Renkin42/82Nix6/README.md

# 82Nix6
An open hardware Nixie Tube Internet Radio alarm clock.
