Renkin42/82Nix6/pcb/clock_exports/display.sch.png

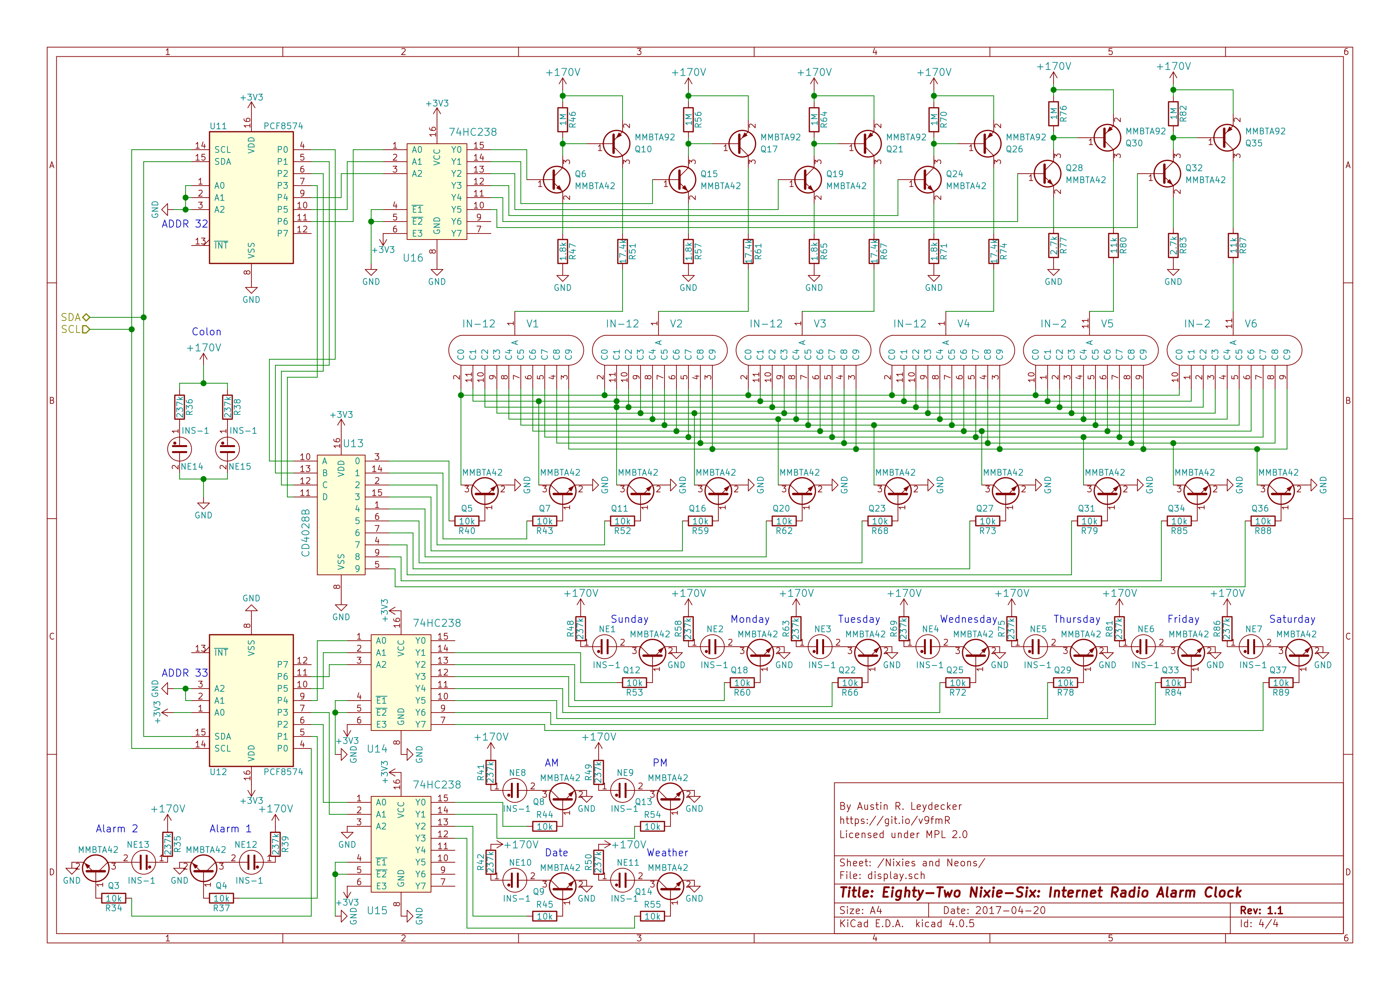
pcb/clock_exports/display.sch.png
