Renkin42/82Nix6/pcb/clock_exports/MP3_Decoder.sch.png

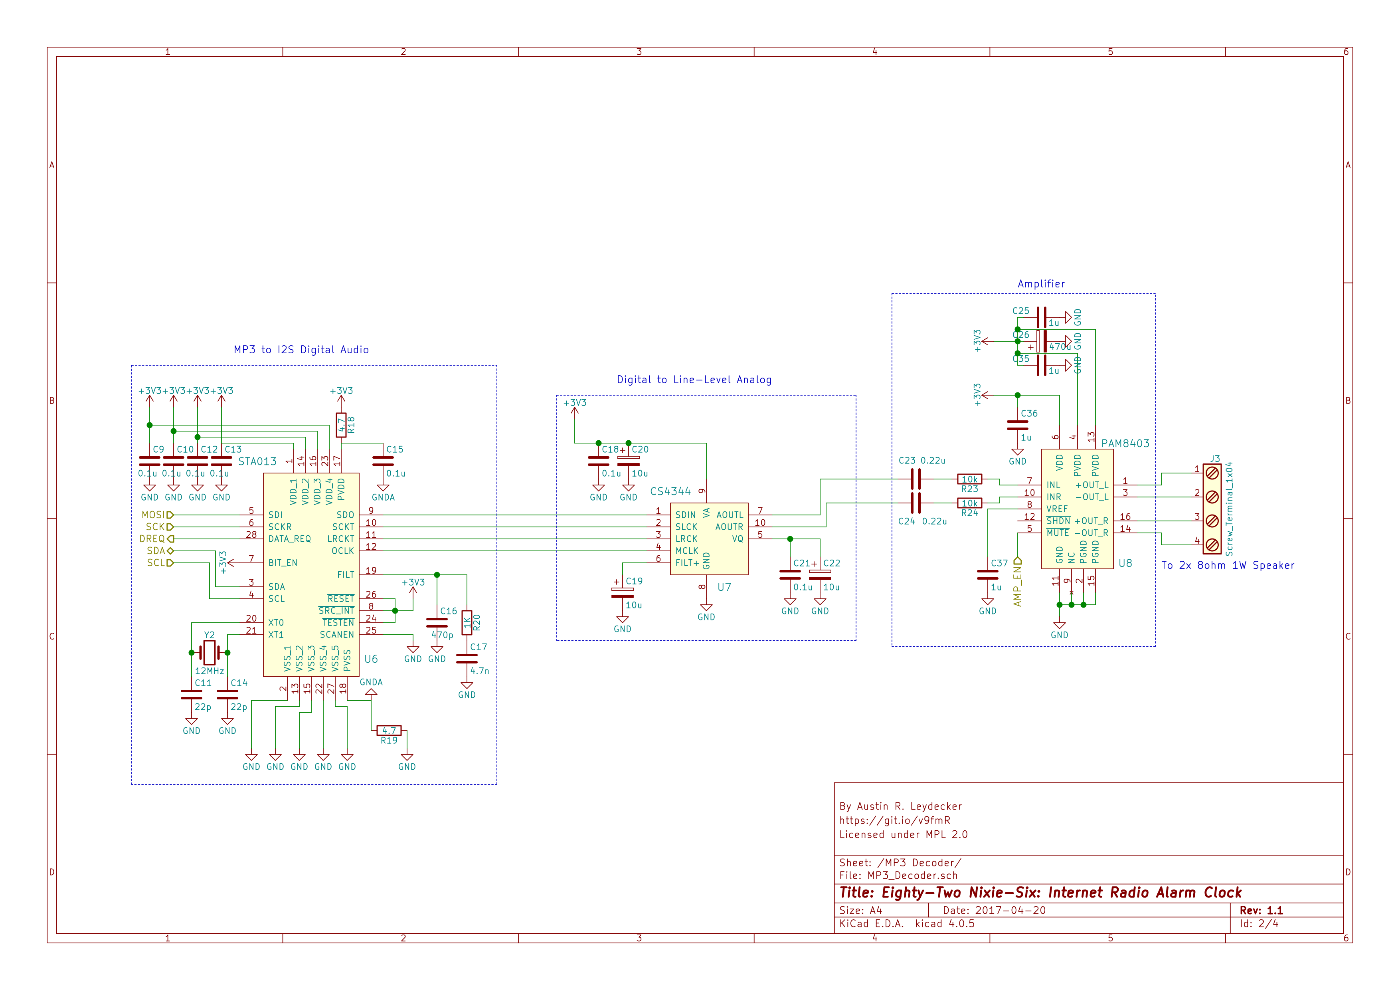
pcb/clock_exports/MP3_Decoder.sch.png
