Renkin42/82Nix6/pcb/clock_exports/NixieClock.sch.png

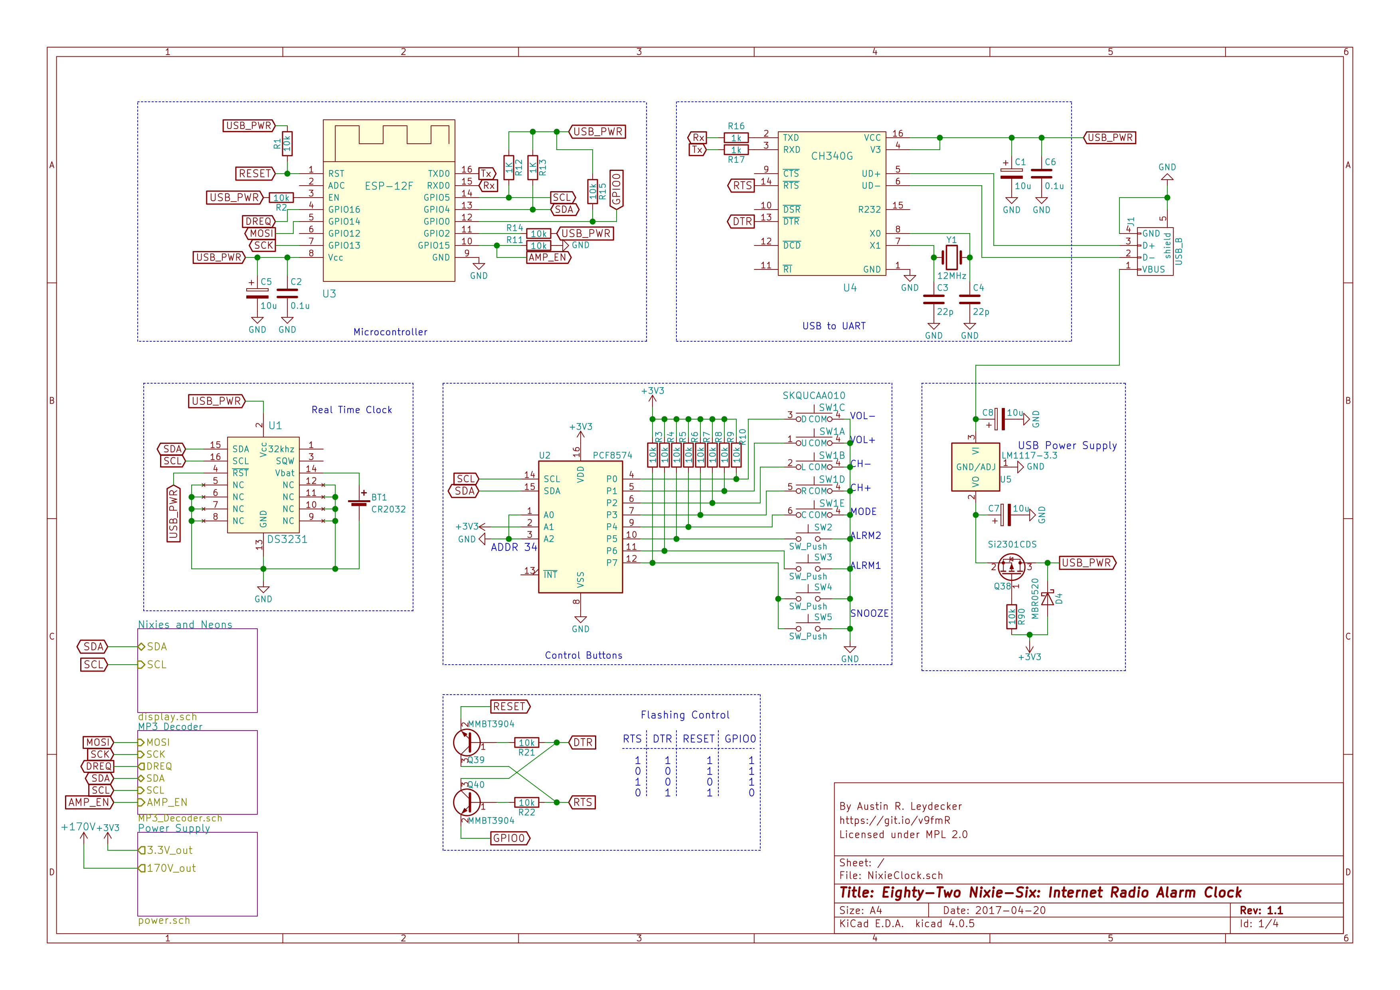
pcb/clock_exports/NixieClock.sch.png
