Renkin42/82Nix6/pcb/clock_exports/power.sch.png

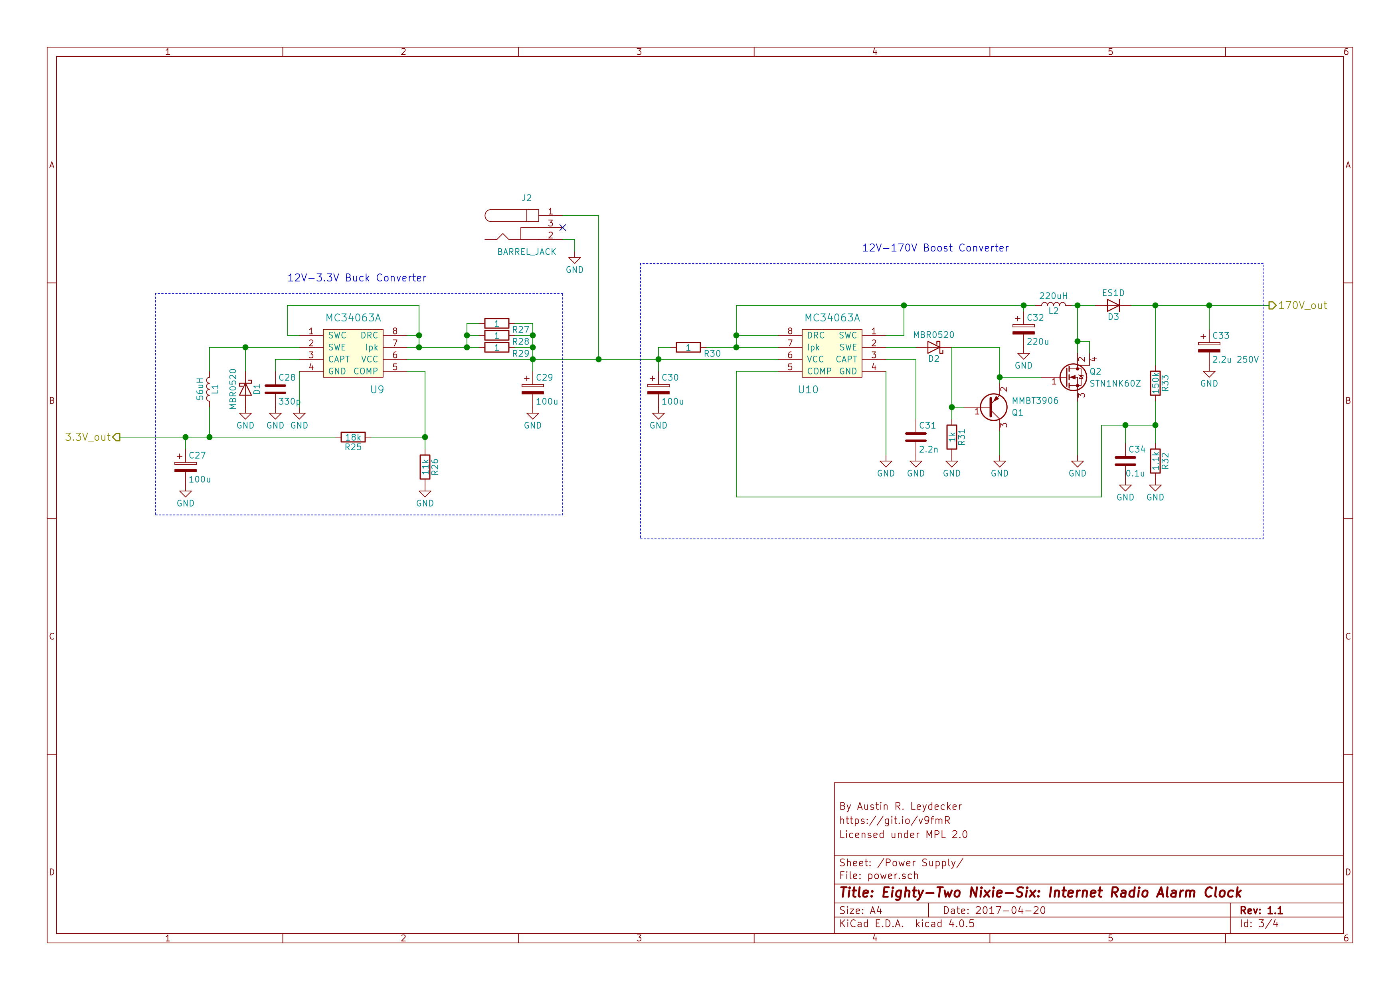
pcb/clock_exports/power.sch.png
