Renkin42/82Nix6/pcb/clock_footprints_3d/ESPModule.FCStd

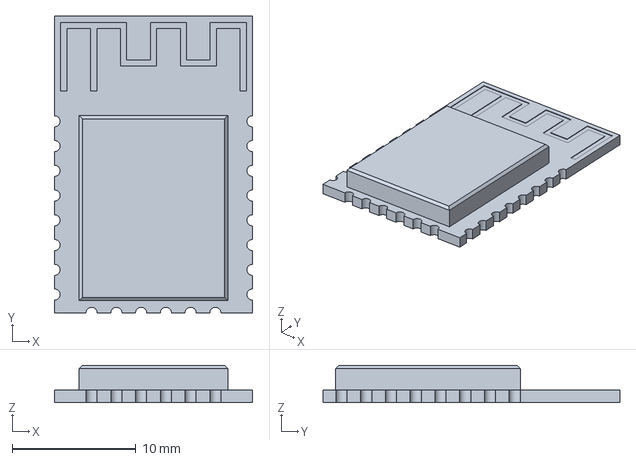
[picture p5: CAD file, 2017-04-18]
pcb/clock_footprints_3d/ESPModule.FCStd
16.0 x 24.0 x 3.00 mm
