Renkin42/82Nix6/pcb/clock_footprints_3d/NixiePin.FCStd

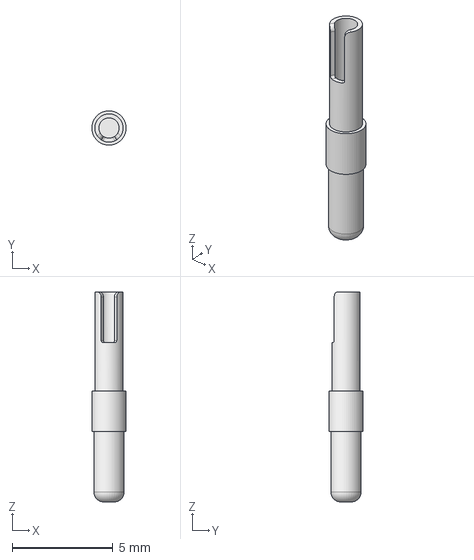
[picture p6: CAD file, 2017-04-11]
pcb/clock_footprints_3d/NixiePin.FCStd
1.70 x 1.70 x 10.4 mm
