Renkin42/82Nix6/pcb/clock_footprints_3d/RadialInductor.FCStd

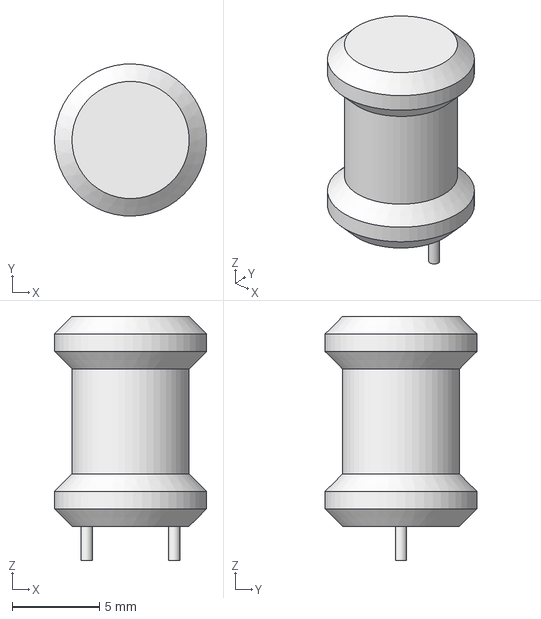
[picture p7: CAD file, 2017-04-11]
pcb/clock_footprints_3d/RadialInductor.FCStd
8.69 x 8.70 x 13.9 mm
