Renkin42/82Nix6/pcb/clock_footprints_3d/BatteryHolder.FCStd

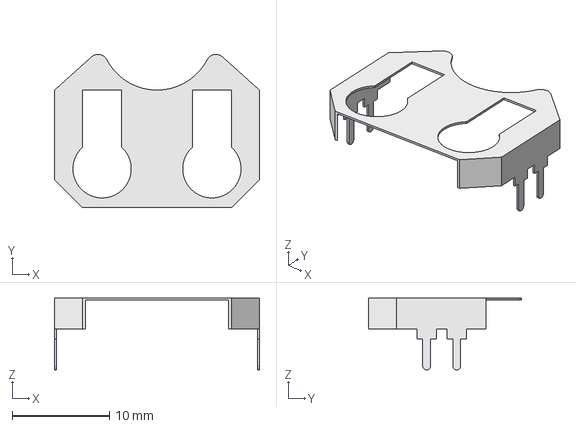
[picture p8: CAD file, 2017-04-11]
pcb/clock_footprints_3d/BatteryHolder.FCStd
21.1 x 15.8 x 7.40 mm
