Renkin42/82Nix6/pcb/clock_footprints_3d/RadialInductor2.FCStd

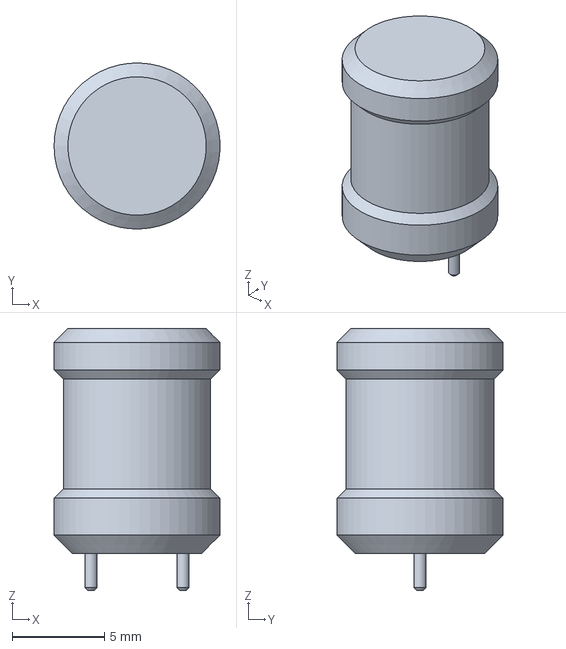
[picture p9: CAD file, 2017-04-11]
pcb/clock_footprints_3d/RadialInductor2.FCStd
8.99 x 9.00 x 14.2 mm
