Renkin42/82Nix6/pcb/clock_exports/NixieClock.pdf

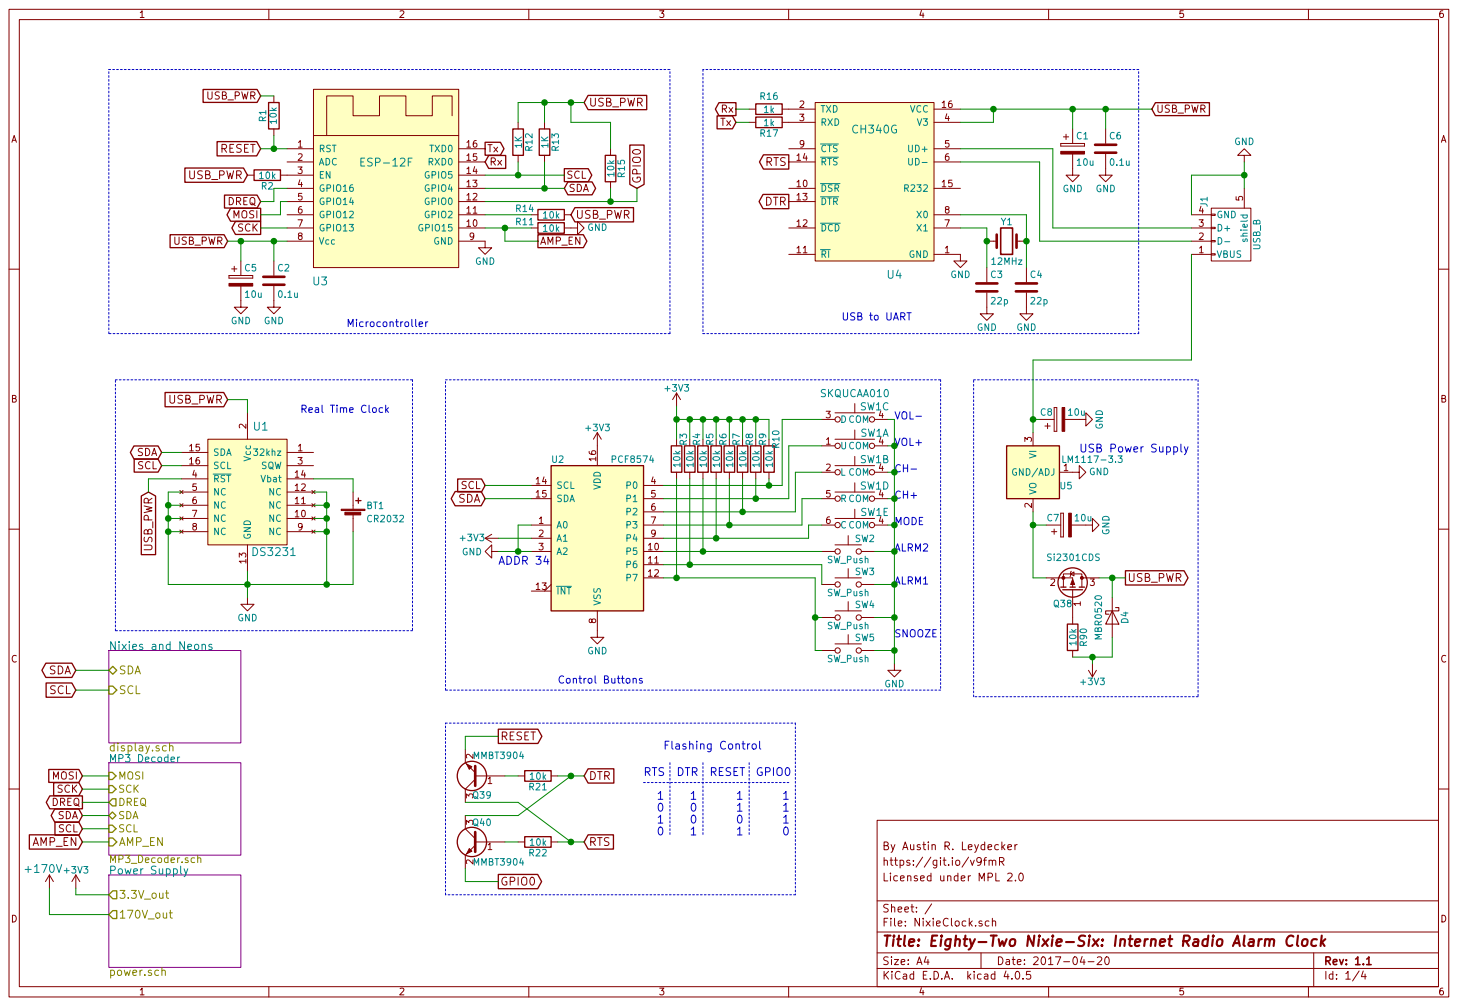
[picture p10: page 1]

5J1 USB_B GND USB to UART C5

By Austin R. Leydecker
https://git.io/v9fmR
File: NixieClock.sch Sheet: / Licensed under MPL 2.0

Id: 1/4 Title: Eighty-Two Nixie-Six: Internet Radio Alarm Clock

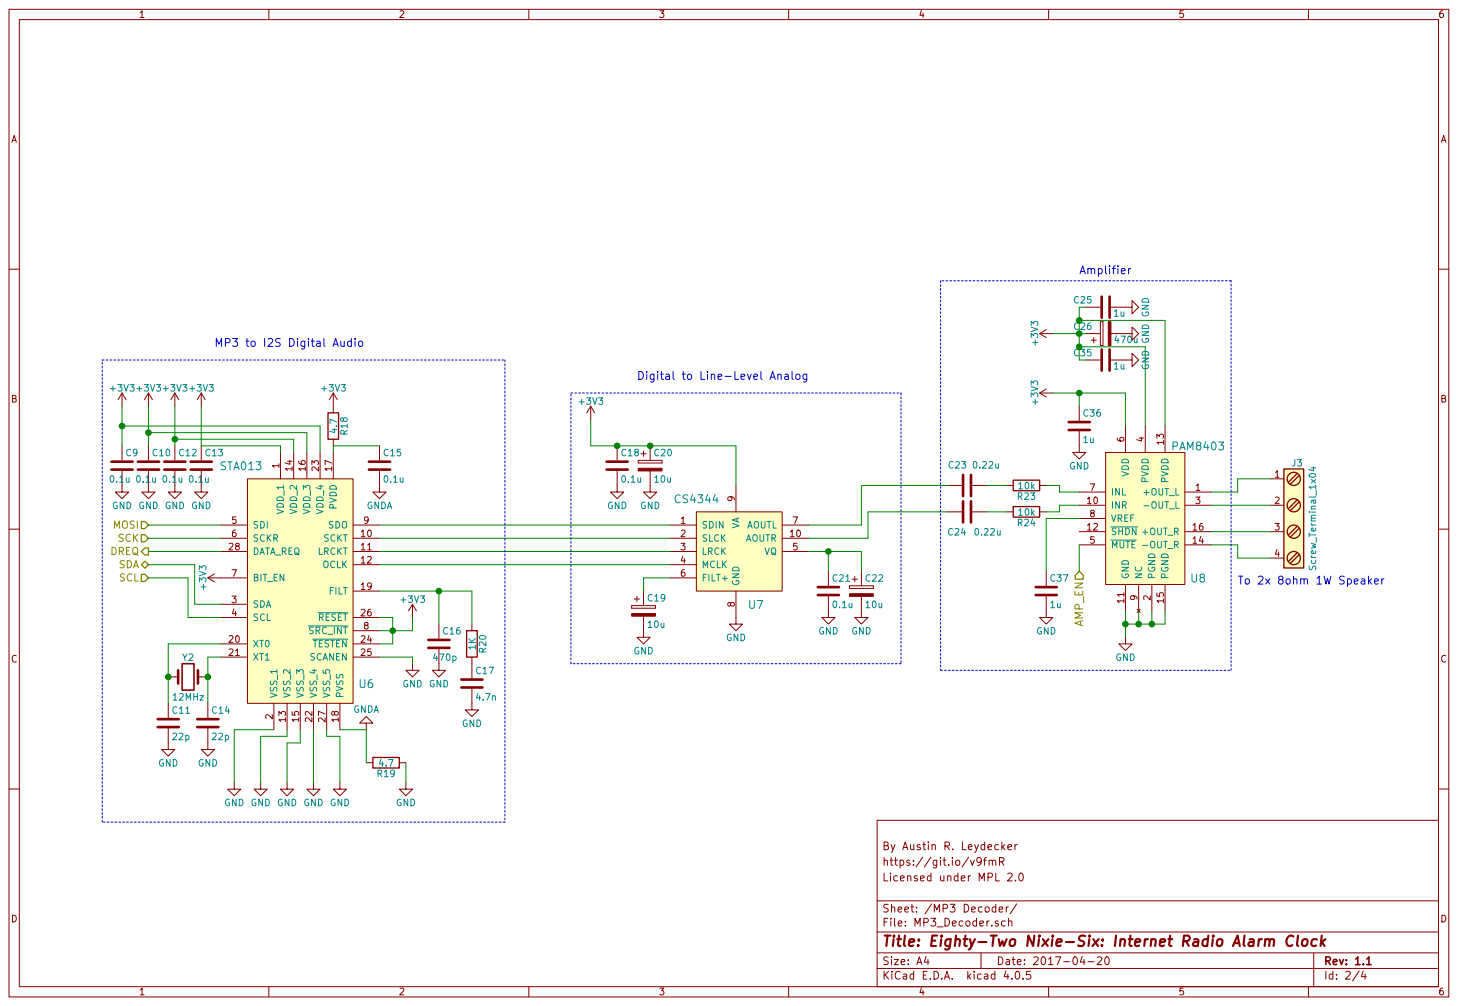
[picture p11: page 2]

Digital to Line-Level Analog

4.7n GND GND MOSI SCK DREQ

2 SDA 3 SCL 4 SDI 5 SCKR 6 BIT_EN 7 SRC_INT 8 SDO 9 SCKT 10 XT0 20

10u GND GND GND GND

https://git.io/v9fmR
File: MP3_Decoder.sch Sheet: /MP3 Decoder/ Licensed under MPL 2.0

Id: 2/4 Title: Eighty-Two Nixie-Six: Internet Radio Alarm Clock

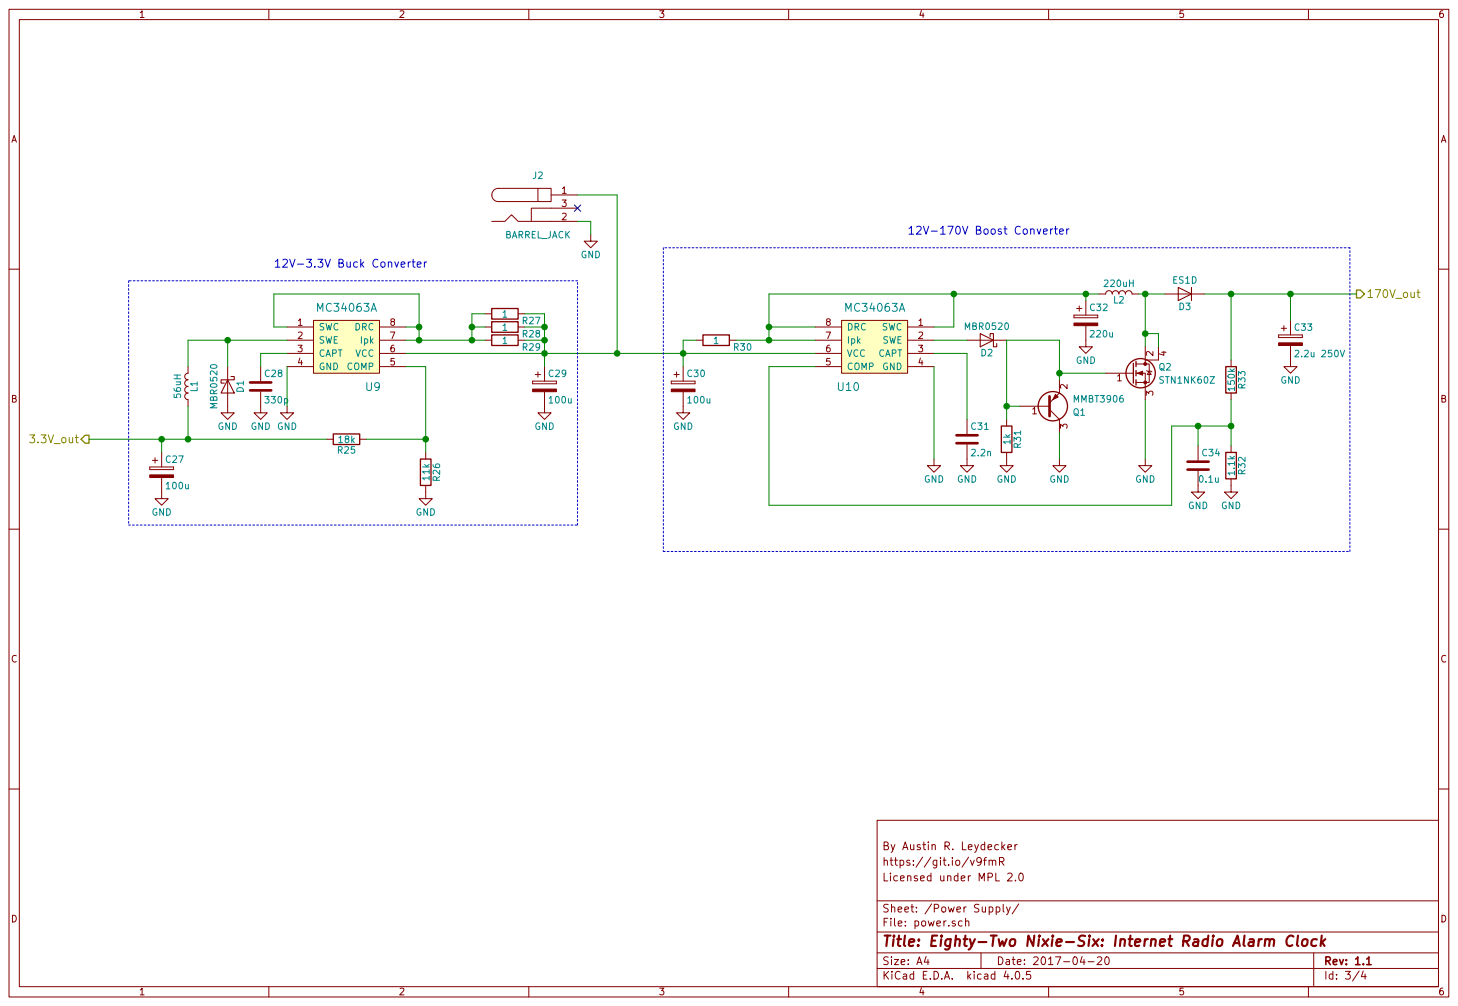
[picture p12: page 3]

By Austin R. Leydecker
https://git.io/v9fmR
Sheet: /Power Supply/ Licensed under MPL 2.0

File: power.sch
Id: 3/4 Title: Eighty-Two Nixie-Six: Internet Radio Alarm Clock

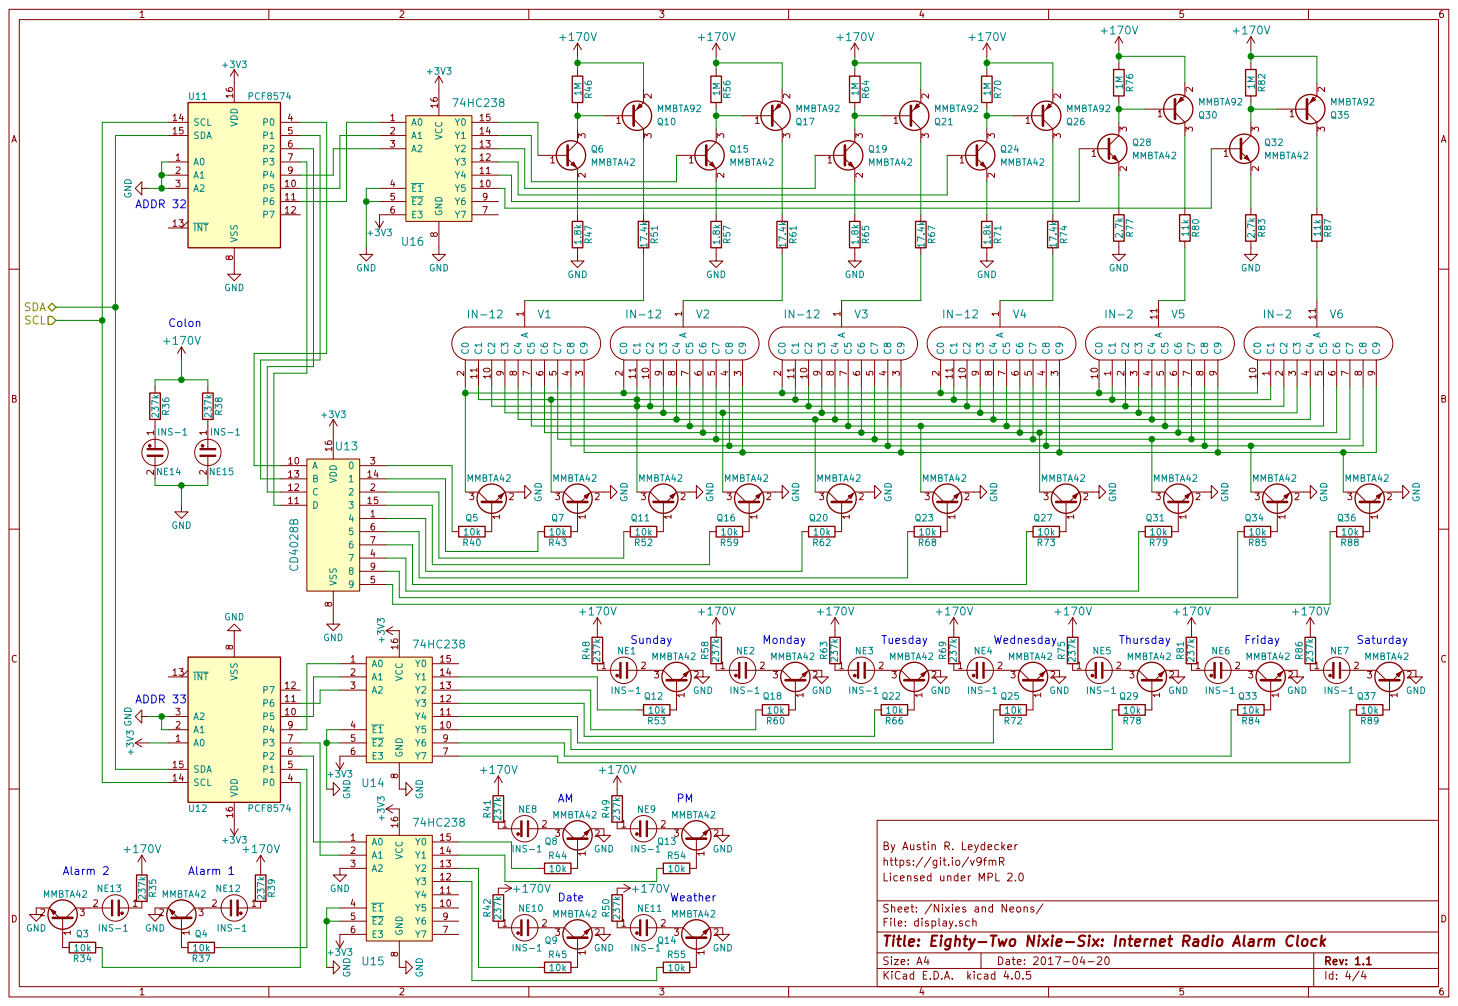
[picture p13: page 4]

INS-1 GND Colon ADDR 32 ADDR 33

2 3 Q24 MMBTA42 1MR70 1.8k R71 R74 17.4k GND GND GND GND

File: display.sch Sheet: /Nixies and Neons/ Licensed under MPL 2.0

Id: 4/4 Title: Eighty-Two Nixie-Six: Internet Radio Alarm Clock
