Renkin42/82Nix6/pcb/NixieClock.kicad_pcb

## KiCad design pcb/NixieClock.kicad_pcb (2017-04-21)

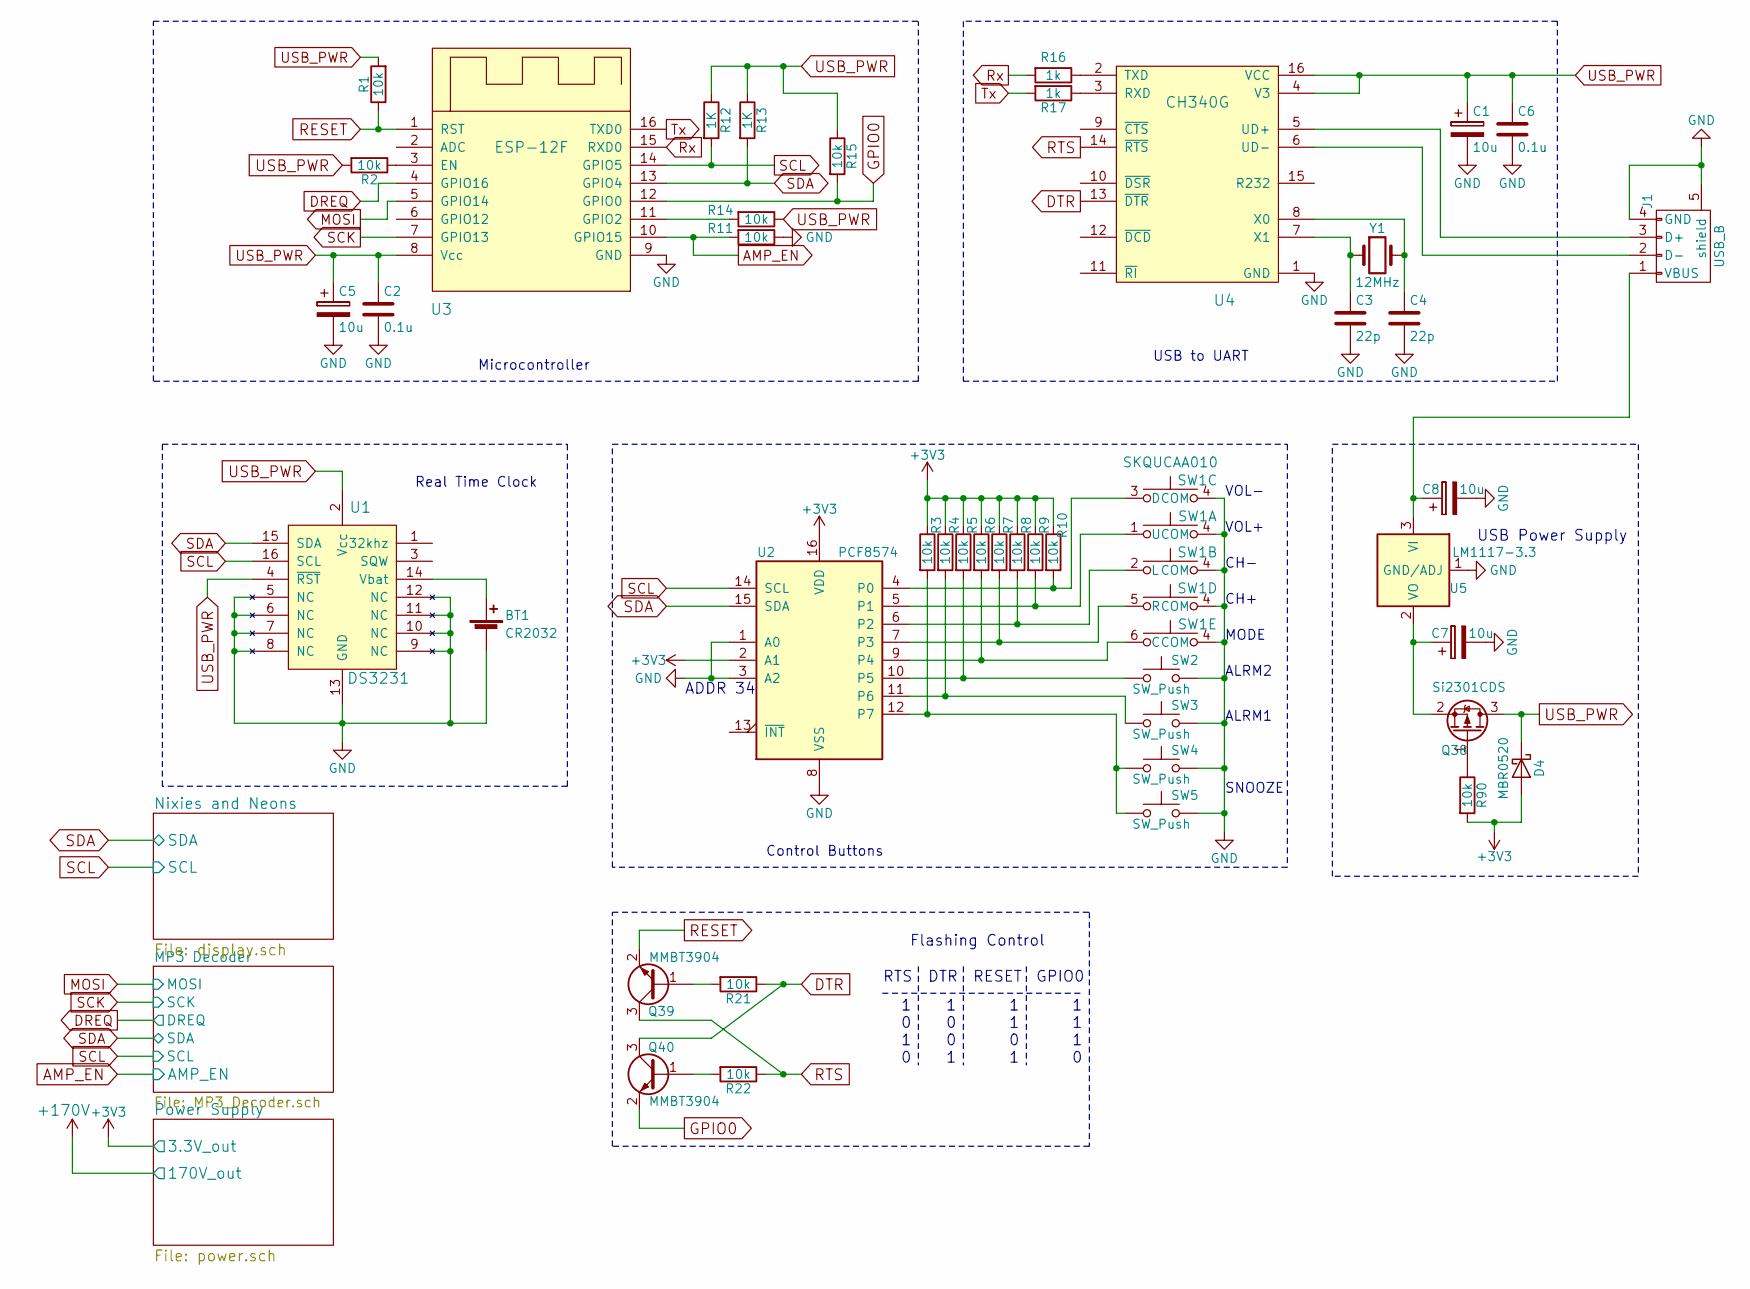
[picture p14: schematic NixieClock.sch, Eighty-Two Nixie-Six: Internet Radio Alarm Clock]

Parts:
BT1: CR2032; Linx_Battery_Holder
C1, C5, C7, C8: 10u; CP_Tantalum_Case-A_EIA-3216-18_Hand
C2, C6: 0.1u; C_0805_HandSoldering
C3, C4: 22p; C_0805_HandSoldering
D4: MBR0520; D_SOD-123
J1: USB_B
Q38: Si2301CDS; SOT-23_Handsoldering
Q39, Q40: MMBT3904; SOT-23_Handsoldering
R1, R2, R3, R4, R5, R6, R7, R8, R9, R10, R11, R14, R15, R21, R22, R90: 10k; R_0805_HandSoldering
R12, R13: 1K; R_0805_HandSoldering
R16, R17: 1k; R_0805_HandSoldering
SW1: SKQUCAA010
SW2, SW3: SW_Push; SW_PUSH_6mm
SW4, SW5: SW_Push; SW_Tactile_SKHH_Angled
U1: DS3231; SOIC-16W_7.5x10.3mm_Pitch1.27mm
U2: PCF8574; SOIC-16W_7.5x10.3mm_Pitch1.27mm
U3: ESP-12F; ESP_SMD_Module
U4: CH340G; SOIC-16_3.9x9.9mm_Pitch1.27mm
U5: LM1117-3.3; SOT-223
Y1: 12MHz; Crystal_HC49-4H_Vertical

Connections:
+3V3: D4.2 (A), R3.1, R4.1, R5.1, R6.1, R7.1, R8.1, R9.1, R10.1, R90.2, U2.2 (A1), U2.16 (VDD); also elsewhere on the board
AMP_EN: R11.2, U3.10 (GPIO15); also elsewhere on the board
DREQ: U3.4 (GPIO16); also elsewhere on the board
DTR: Q40.3 (C), R21.1, U4.13 (~DTR)
GND: BT1.2 (-), C1.2, C2.2, C3.2, C4.2, C5.2, C6.2, C7.2, C8.2, J1.4 (GND), J1.5 (shield), R11.1, SW1.4 (COM), SW2.2, SW3.2, SW4.2, SW5.2, U1.5 (NC), U1.6 (NC), U1.7 (NC), U1.8 (NC), U1.9 (NC), U1.10 (NC), U1.11 (NC), U1.12 (NC), U1.13 (GND), U2.1 (A0), U2.3 (A2), U2.8 (VSS), U3.9 (GND), U4.1 (GND), U5.1 (GND/ADJ); also elsewhere on the board
GPIO0: Q40.2 (E), R15.2, U3.12 (GPIO0)
MOSI: U3.5 (GPIO14); also elsewhere on the board
unnamed: BT1.1 (+), U1.14 (Vbat)
unnamed: C3.1, U4.7 (X1), Y1.1
unnamed: C4.1, U4.8 (X0), Y1.2
unnamed: C7.1, Q38.2 (S), U5.2 (VO), U5.4 (VO)
unnamed: C8.1, J1.1 (VBUS), U5.3 (VI)
unnamed: J1.2 (D-), U4.6 (UD-)
unnamed: J1.3 (D+), U4.5 (UD+)
unnamed: Q38.1 (G), R90.1
unnamed: Q39.1 (B), R21.2
unnamed: Q40.1 (B), R22.2
unnamed: R2.1, U3.3 (EN)
unnamed: R3.2, SW4.1, SW5.1, U2.12 (P7)
unnamed: R4.2, SW3.1, U2.11 (P6)
unnamed: R5.2, SW2.1, U2.10 (P5)
unnamed: R6.2, SW1.6 (C), U2.9 (P4)
unnamed: R7.2, SW1.5 (R), U2.7 (P3)
unnamed: R8.2, SW1.2 (L), U2.6 (P2)
unnamed: R9.2, SW1.1 (U), U2.5 (P1)
unnamed: R10.2, SW1.3 (D), U2.4 (P0)
unnamed: R14.2, U3.11 (GPIO2)
unnamed: R16.1, U4.2 (TXD)
unnamed: R17.1, U4.3 (RXD)
RESET: Q39.2 (E), R1.1, U3.1 (RST)
RTS: Q39.3 (C), R22.1, U4.14 (~RTS)
Rx: R16.2, U3.15 (RXD0)
SCK: U3.7 (GPIO13); also elsewhere on the board
SCL: R12.2, U1.16 (SCL), U2.14 (SCL), U3.14 (GPIO5); also elsewhere on the board
SDA: R13.2, U1.15 (SDA), U2.15 (SDA), U3.13 (GPIO4); also elsewhere on the board
Tx: R17.2, U3.16 (TXD0)
USB_PWR: C1.1, C2.1, C5.1, C6.1, D4.1 (K), Q38.3 (D), R1.2, R2.2, R12.1, R13.1, R14.1, R15.1, U1.2 (Vcc), U1.4 (~RST), U3.8 (Vcc), U4.4 (V3), U4.16 (VCC)

Notes on the sheet:
ADDR 34
Microcontroller
Control Buttons
VOL+
VOL-
CH-
CH+
MODE
ALRM1
ALRM2
SNOOZE
Real Time Clock
USB to UART
USB Power Supply
RTS
DTR
RESET
GPIO0
1 0 1 0
1 0 0 1
1 1 0 1
1 1 1 0
Flashing Control

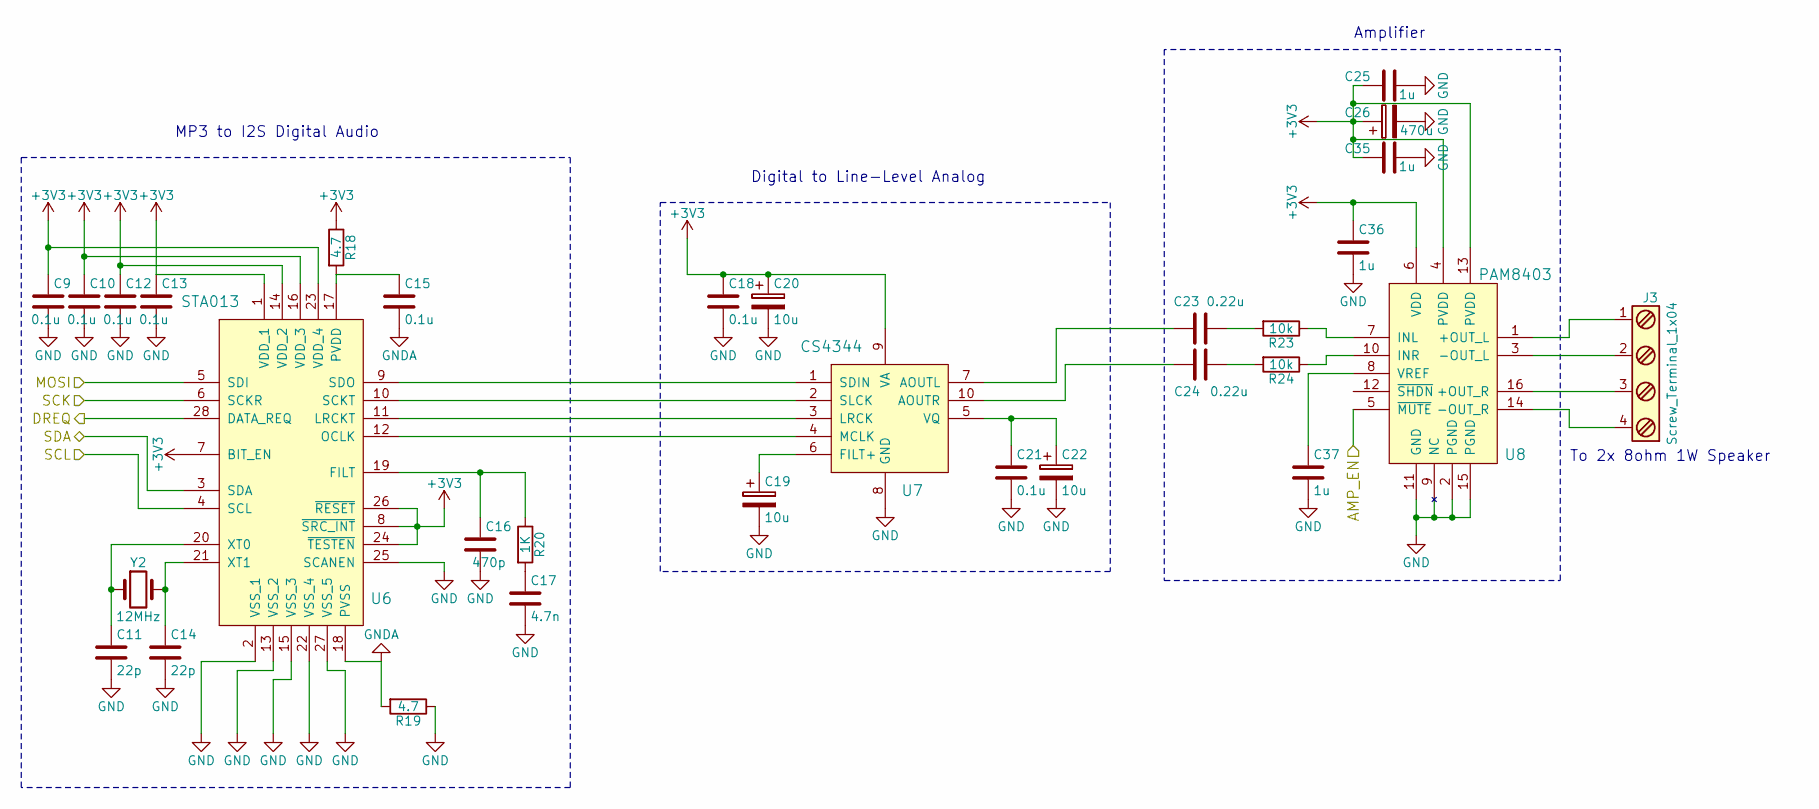
[picture p15: schematic MP3_Decoder.sch, Eighty-Two Nixie-Six: Internet Radio Alarm Clock]

Parts:
C9, C10, C12, C13, C15, C18, C21: 0.1u; C_0805_HandSoldering
C11, C14: 22p; C_0805_HandSoldering
C16: 470p; C_0805_HandSoldering
C17: 4.7n; C_0805_HandSoldering
C19, C20, C22: 10u; CP_Tantalum_Case-A_EIA-3216-18_Hand
C23, C24: 0.22u; C_0805_HandSoldering
C25, C35, C36, C37: 1u; C_0805_HandSoldering
C26: 470u; CP_Radial_D6.3mm_P2.50mm
J3: Screw_Terminal_1x04; TerminalBlock_Pheonix_MPT-2.54mm_4pol
R18, R19: 4.7; R_0805_HandSoldering
R20: 1K; R_0805_HandSoldering
R23, R24: 10k; R_0805_HandSoldering
U6: STA013; SOIC-28W_7.5x17.9mm_Pitch1.27mm
U7: CS4344; MSOP-10_3x3mm_Pitch0.5mm
U8: PAM8403; SOIC-16_3.9x9.9mm_Pitch1.27mm
Y2: 12MHz; Crystal_HC49-4H_Vertical

Connections:
+3V3: C9.1, C10.1, C12.1, C13.1, C18.1, C20.1, C25.1, C26.1, C35.1, C36.1, R18.1, U6.1 (VDD_1), U6.7 (BIT_EN), U6.8 (~SRC_INT), U6.14 (VDD_2), U6.16 (VDD_3), U6.23 (VDD_4), U6.24 (~TESTEN), U6.26 (~RESET), U7.9 (VA), U8.4 (PVDD), U8.6 (VDD), U8.13 (PVDD); also elsewhere on the board
AMP_EN: U8.5 (~MUTE); also elsewhere on the board
DREQ: U6.28 (DATA_REQ); also elsewhere on the board
GND: C9.2, C10.2, C11.2, C12.2, C13.2, C14.2, C16.2, C17.2, C18.2, C19.2, C20.2, C21.2, C22.2, C25.2, C26.2, C35.2, C36.2, C37.2, R19.1, U6.2 (VSS_1), U6.13 (VSS_2), U6.15 (VSS_3), U6.22 (VSS_4), U6.25 (SCANEN), U6.27 (VSS_5), U7.8 (GND), U8.2 (PGND), U8.9 (NC), U8.11 (GND), U8.15 (PGND); also elsewhere on the board
GNDA: C15.2, R19.2, U6.18 (PVSS)
MOSI: U6.5 (SDI); also elsewhere on the board
unnamed: C11.1, U6.20 (XT0), Y2.1
unnamed: C14.1, U6.21 (XT1), Y2.2
unnamed: C15.1, R18.2, U6.17 (PVDD)
unnamed: C16.1, R20.1, U6.19 (FILT)
unnamed: C17.1, R20.2
unnamed: C19.1, U7.6 (FILT+)
unnamed: C21.1, C22.1, U7.5 (VQ)
unnamed: C23.1, U7.7 (AOUTL)
unnamed: C23.2, R23.2
unnamed: C24.1, R24.2
unnamed: C24.2, U7.10 (AOUTR)
unnamed: C37.1, U8.8 (VREF)
unnamed: J3.1, U8.1 (+OUT_L)
unnamed: J3.2, U8.3 (-OUT_L)
unnamed: J3.3, U8.16 (+OUT_R)
unnamed: J3.4, U8.14 (-OUT_R)
unnamed: R23.1, U8.7 (INL)
unnamed: R24.1, U8.10 (INR)
unnamed: U6.9 (SDO), U7.1 (SDIN)
unnamed: U6.10 (SCKT), U7.2 (SLCK)
unnamed: U6.11 (LRCKT), U7.3 (LRCK)
unnamed: U6.12 (OCLK), U7.4 (MCLK)
SCK: U6.6 (SCKR); also elsewhere on the board
SCL: U6.4 (SCL); also elsewhere on the board
SDA: U6.3 (SDA); also elsewhere on the board

Notes on the sheet:
MP3 to I2S Digital Audio
Digital to Line-Level Analog
Amplifier
To 2x 8ohm 1W Speaker

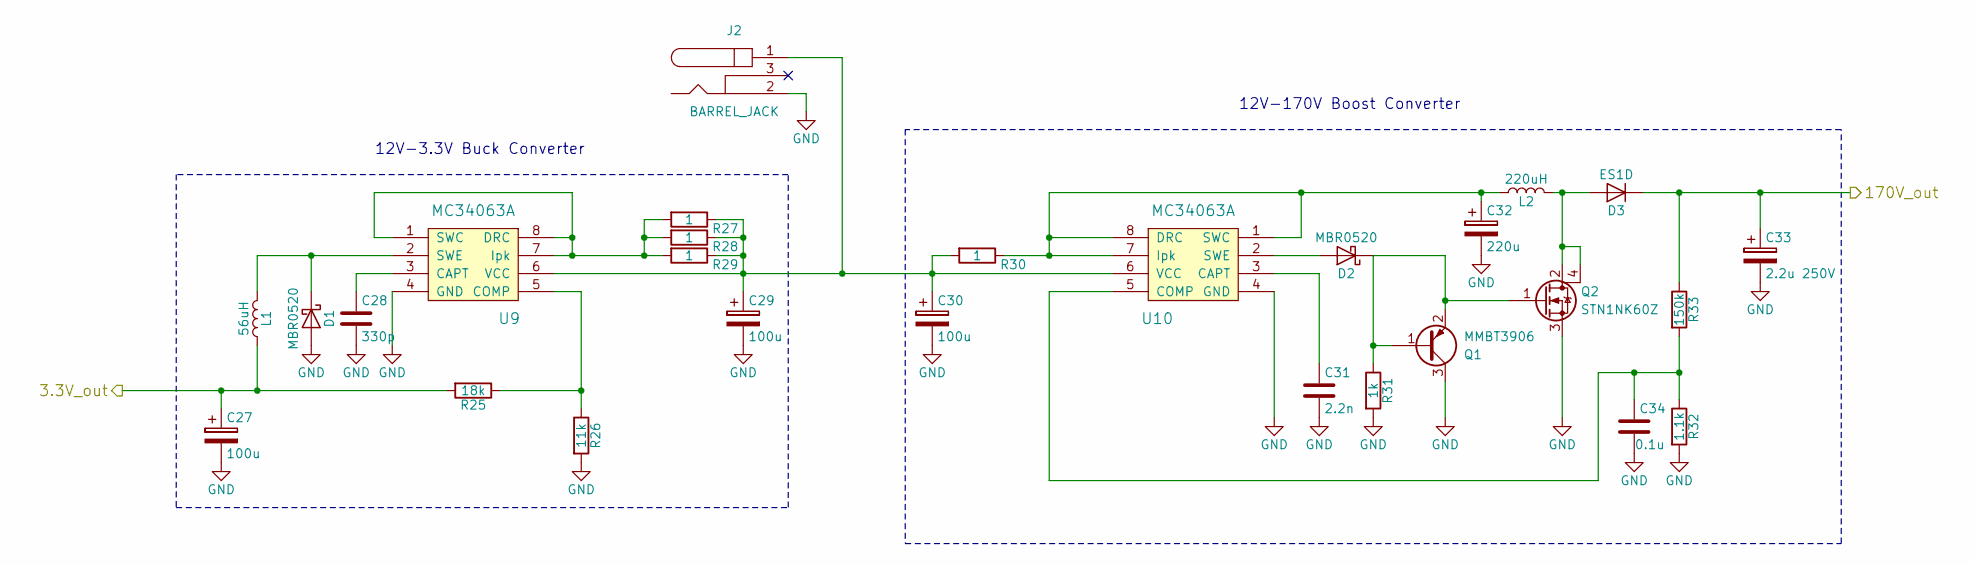
[picture p16: schematic power.sch, Eighty-Two Nixie-Six: Internet Radio Alarm Clock]

Parts:
C27, C29, C30: 100u; CP_Radial_D5.0mm_P2.50mm
C28: 330p; C_0805_HandSoldering
C31: 2.2n; C_0805_HandSoldering
C32: 220u; CP_Radial_D6.3mm_P2.50mm
C33: 2.2u 250V; CP_Radial_D6.3mm_P2.50mm
C34: 0.1u; C_0805_HandSoldering
D1, D2: MBR0520; D_SOD-123
D3: ES1D; D_SOD-123
J2: BARREL_JACK
L1: 56uH; Bourns_RLB9012
L2: 220uH; Bourns_RLB0914
Q1: MMBT3906; SOT-23_Handsoldering
Q2: STN1NK60Z; SOT-223
R25: 18k; R_1206_HandSoldering
R26: 11k; R_1206_HandSoldering
R27, R28, R29, R30: 1; R_0805_HandSoldering
R31: 1k; R_0805_HandSoldering
R32: 1.1k; R_1206_HandSoldering
R33: 150k; R_1206_HandSoldering
U9, U10: MC34063A; SOIC-8_3.9x4.9mm_Pitch1.27mm

Connections:
+3V3: C27.1, L1.2, R25.2; also elsewhere on the board
+170V: C33.1, D3.1 (K), R33.1; also elsewhere on the board
GND: C27.2, C28.2, C29.2, C30.2, C31.2, C32.2, C33.2, C34.2, D1.2 (A), J2.2, Q1.3 (C), Q2.3 (S), R26.2, R31.2, R32.2, U9.4 (GND), U10.4 (GND); also elsewhere on the board
unnamed: C28.1, U9.3 (CAPT)
unnamed: C29.1, C30.1, J2.1, R27.1, R28.1, R29.1, R30.2, U9.6 (VCC), U10.6 (VCC)
unnamed: C31.1, U10.3 (CAPT)
unnamed: C32.1, L2.2, R30.1, U10.1 (SWC), U10.7 (Ipk), U10.8 (DRC)
unnamed: C34.1, R32.1, R33.2, U10.5 (COMP)
unnamed: D1.1 (K), L1.1, U9.2 (SWE)
unnamed: D2.1 (K), Q1.1 (B), Q1.2 (E), Q2.1 (G), R31.1
unnamed: D2.2 (A), U10.2 (SWE)
unnamed: D3.2 (A), L2.1, Q2.2 (D), Q2.4 (D)
unnamed: R25.1, R26.1, U9.5 (COMP)
unnamed: R27.2, R28.2, R29.2, U9.1 (SWC), U9.7 (Ipk), U9.8 (DRC)

Notes on the sheet:
12V-170V Boost Converter
12V-3.3V Buck Converter

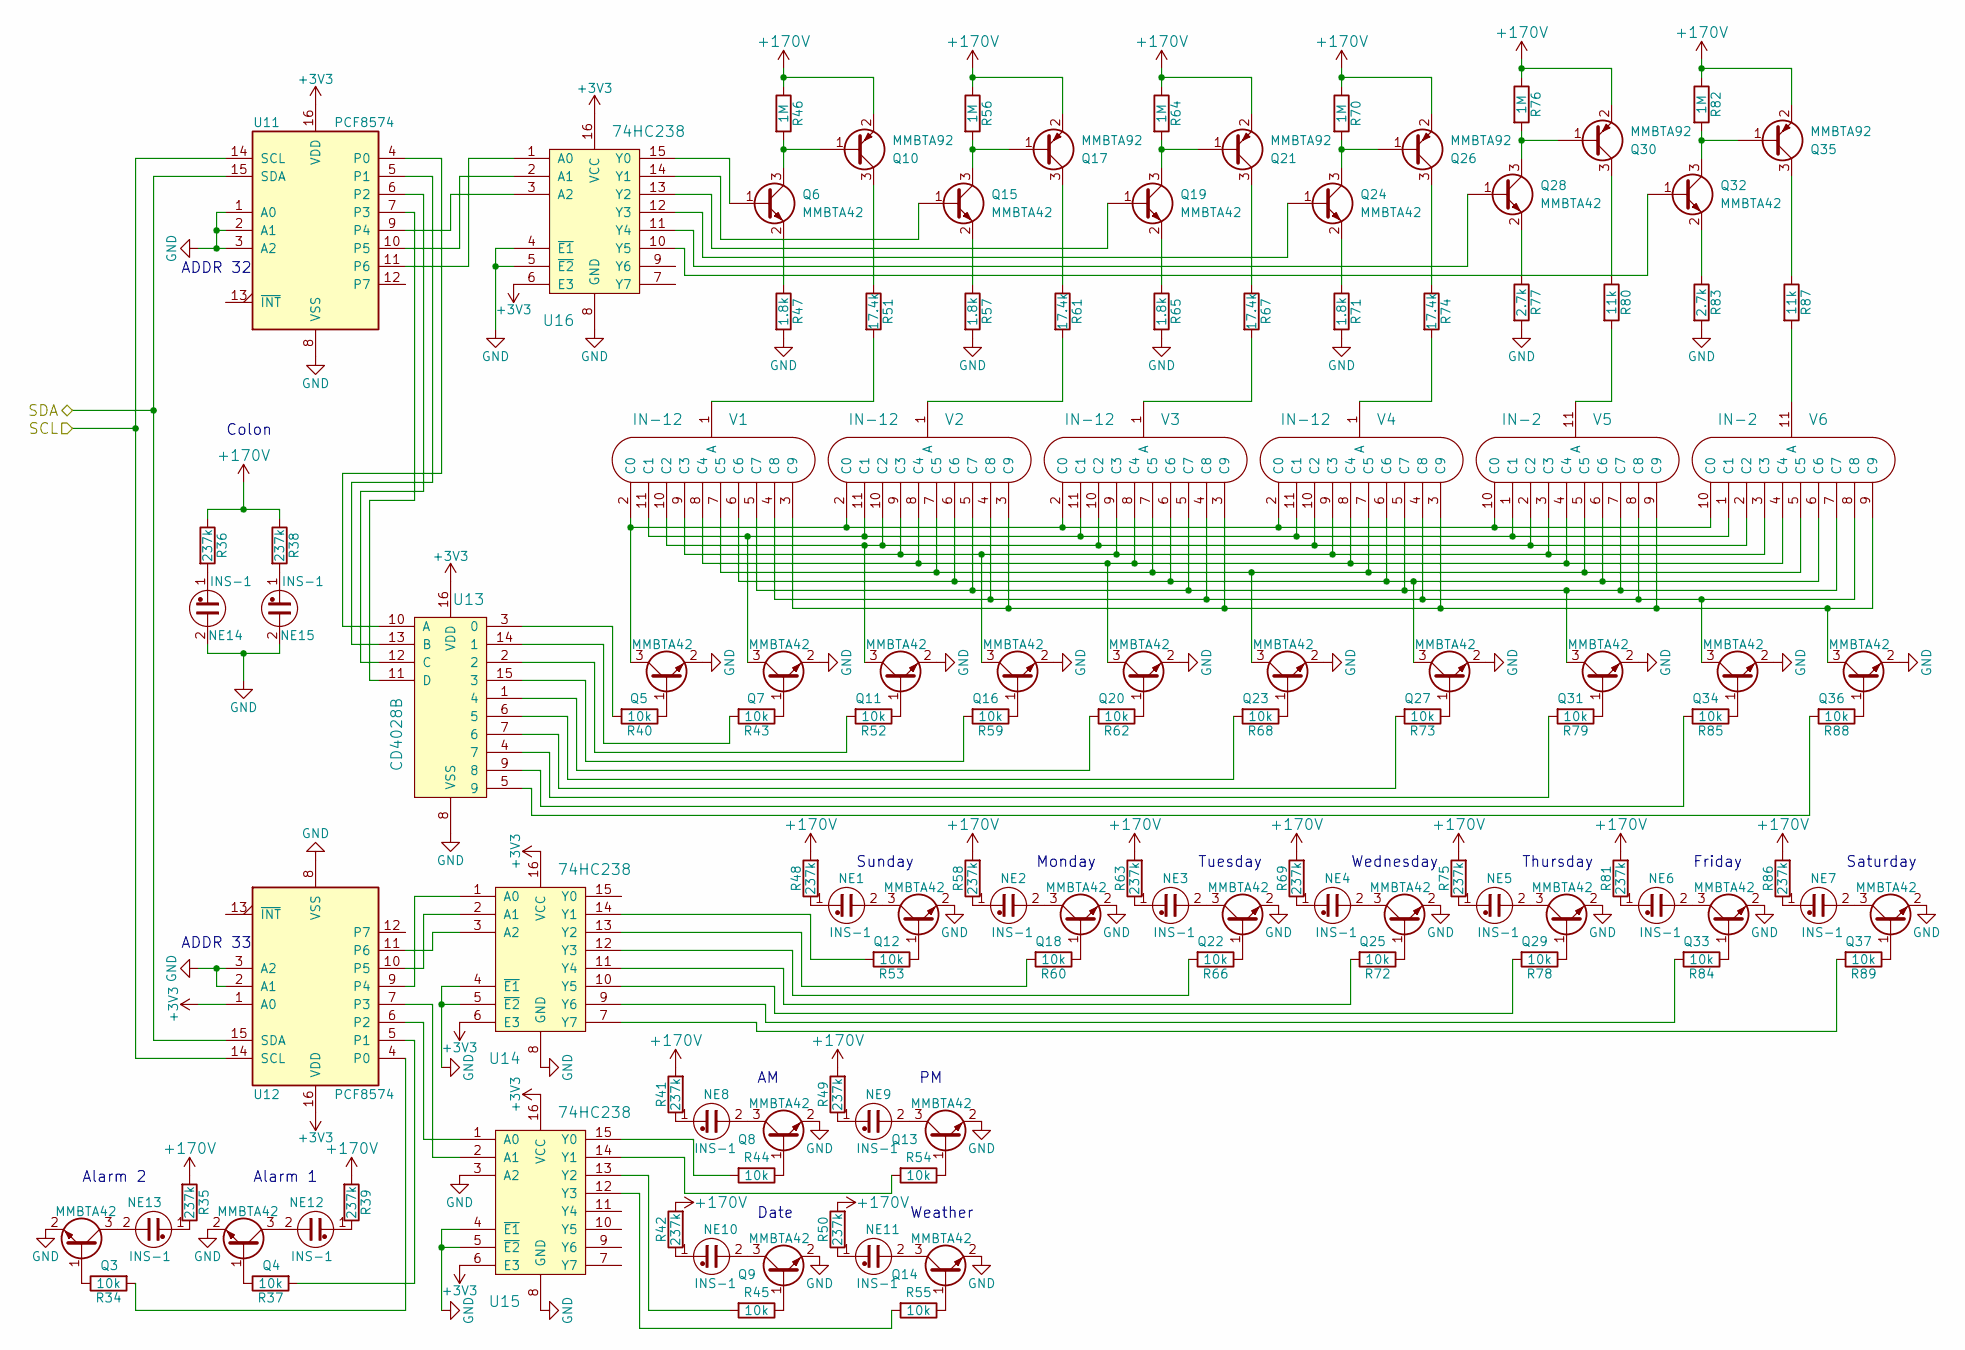
[picture p17: schematic display.sch, Eighty-Two Nixie-Six: Internet Radio Alarm Clock]

Parts:
NE1, NE2, NE3, NE4, NE5, NE6, NE7, NE8, NE9, NE10, NE11, NE12, NE13, NE14, NE15: INS-1
Q3, Q4, Q5, Q6, Q7, Q8, Q9, Q11, Q12, Q13, Q14, Q15, Q16, Q18, Q19, Q20, Q22, Q23, Q24, Q25, Q27, Q28, Q29, Q31, Q32, Q33, Q34, Q36, Q37: MMBTA42; SOT-23_Handsoldering
Q10, Q17, Q21, Q26, Q30, Q35: MMBTA92; SOT-23_Handsoldering
R34, R37, R40, R43, R44, R45, R52, R53, R54, R55, R59, R60, R62, R66, R68, R72, R73, R78, R79, R84, R85, R88, R89: 10k; R_0805_HandSoldering
R35, R36, R38, R39, R41, R42, R48, R49, R50, R58, R63, R69, R75, R81, R86: 237k; R_1206_HandSoldering
R46, R56, R64, R70, R76, R82: 1M; R_1206_HandSoldering
R47, R57, R65, R71: 1.8k; R_1206_HandSoldering
R51, R61, R67, R74: 17.4k; R_1206_HandSoldering
R77, R83: 2.7k; R_1206_HandSoldering
R80, R87: 11k; R_1206_HandSoldering
U11, U12: PCF8574; SOIC-18W_7.5x11.6mm_Pitch1.27mm
U13: CD4028B; SOIC-16_3.9x9.9mm_Pitch1.27mm
U14, U15, U16: 74HC238; SOIC-16_3.9x9.9mm_Pitch1.27mm
V1, V2, V3, V4: IN-12
V5, V6: IN-2

Connections:
+3V3: U11.16 (VDD), U12.1 (A0), U12.16 (VDD), U13.16 (VDD), U14.6 (E3), U14.16 (VCC), U15.6 (E3), U15.16 (VCC), U16.6 (E3), U16.16 (VCC); also elsewhere on the board
+170V: Q10.2 (E), Q17.2 (E), Q21.2 (E), Q26.2 (E), Q30.2 (E), Q35.2 (E), R35.2, R36.1, R38.1, R39.2, R41.2, R42.2, R46.1, R48.2, R49.2, R50.2, R56.1, R58.2, R63.2, R64.1, R69.2, R70.1, R75.2, R76.1, R81.2, R82.1, R86.2; also elsewhere on the board
GND: NE14.2, NE15.2, Q3.2 (E), Q4.2 (E), Q5.2 (E), Q7.2 (E), Q8.2 (E), Q9.2 (E), Q11.2 (E), Q12.2 (E), Q13.2 (E), Q14.2 (E), Q16.2 (E), Q18.2 (E), Q20.2 (E), Q22.2 (E), Q23.2 (E), Q25.2 (E), Q27.2 (E), Q29.2 (E), Q31.2 (E), Q33.2 (E), Q34.2 (E), Q36.2 (E), Q37.2 (E), R47.2, R57.2, R65.2, R71.2, R77.2, R83.2, U11.1 (A0), U11.2 (A1), U11.3 (A2), U11.8 (VSS), U12.2 (A1), U12.3 (A2), U12.8 (VSS), U13.8 (VSS), U14.4 (~E1), U14.5 (~E2), U14.8 (GND), U15.3 (A2), U15.4 (~E1), U15.5 (~E2), U15.8 (GND), U16.4 (~E1), U16.5 (~E2), U16.8 (GND); also elsewhere on the board
unnamed: NE1.1, R48.1
unnamed: NE1.2, Q12.3 (C)
unnamed: NE2.1, R58.1
unnamed: NE2.2, Q18.3 (C)
unnamed: NE3.1, R63.1
unnamed: NE3.2, Q22.3 (C)
unnamed: NE4.1, R69.1
unnamed: NE4.2, Q25.3 (C)
unnamed: NE5.1, R75.1
unnamed: NE5.2, Q29.3 (C)
unnamed: NE6.1, R81.1
unnamed: NE6.2, Q33.3 (C)
unnamed: NE7.1, R86.1
unnamed: NE7.2, Q37.3 (C)
unnamed: NE8.1, R41.1
unnamed: NE8.2, Q8.3 (C)
unnamed: NE9.1, R49.1
unnamed: NE9.2, Q13.3 (C)
unnamed: NE10.1, R42.1
unnamed: NE10.2, Q9.3 (C)
unnamed: NE11.1, R50.1
unnamed: NE11.2, Q14.3 (C)
unnamed: NE12.1, R39.1
unnamed: NE12.2, Q4.3 (C)
unnamed: NE13.1, R35.1
unnamed: NE13.2, Q3.3 (C)
unnamed: NE14.1, R36.2
unnamed: NE15.1, R38.2
unnamed: Q3.1 (B), R34.1
unnamed: Q4.1 (B), R37.1
unnamed: Q5.1 (B), R40.1
unnamed: Q5.3 (C), V1.2 (C0), V2.2 (C0), V3.2 (C0), V4.2 (C0), V5.10 (C0), V6.10 (C0)
unnamed: Q6.1 (B), U16.15 (Y0)
unnamed: Q6.2 (E), R47.1
unnamed: Q7.1 (B), R43.1
unnamed: Q7.3 (C), V1.11 (C1), V2.11 (C1), V3.11 (C1), V4.11 (C1), V5.1 (C1), V6.1 (C1)
unnamed: Q8.1 (B), R44.1
unnamed: Q9.1 (B), R45.1
unnamed: Q6.3 (C), Q10.1 (B), R46.2
unnamed: Q10.3 (C), R51.1
unnamed: Q11.1 (B), R52.1
unnamed: Q11.3 (C), V1.10 (C2), V2.10 (C2), V3.10 (C2), V4.10 (C2), V5.2 (C2), V6.2 (C2)
unnamed: Q12.1 (B), R53.1
unnamed: Q13.1 (B), R54.1
unnamed: Q14.1 (B), R55.1
unnamed: Q15.1 (B), U16.14 (Y1)
unnamed: Q15.2 (E), R57.1
unnamed: Q15.3 (C), Q17.1 (B), R56.2
unnamed: Q16.1 (B), R59.1
unnamed: Q16.3 (C), V1.9 (C3), V2.9 (C3), V3.9 (C3), V4.9 (C3), V5.3 (C3), V6.3 (C3)
unnamed: Q17.3 (C), R61.1
unnamed: Q18.1 (B), R60.1
unnamed: Q19.1 (B), U16.13 (Y2)
unnamed: Q19.2 (E), R65.1
unnamed: Q19.3 (C), Q21.1 (B), R64.2
unnamed: Q20.1 (B), R62.1
unnamed: Q20.3 (C), V1.8 (C4), V2.8 (C4), V3.8 (C4), V4.8 (C4), V5.4 (C4), V6.4 (C4)
unnamed: Q21.3 (C), R67.1
unnamed: Q22.1 (B), R66.1
unnamed: Q23.1 (B), R68.1
unnamed: Q23.3 (C), V1.7 (C5), V2.7 (C5), V3.7 (C5), V4.7 (C5), V5.5 (C5), V6.5 (C5)
unnamed: Q24.1 (B), U16.12 (Y3)
unnamed: Q24.2 (E), R71.1
unnamed: Q24.3 (C), Q26.1 (B), R70.2
unnamed: Q25.1 (B), R72.1
unnamed: Q26.3 (C), R74.1
unnamed: Q27.1 (B), R73.1
unnamed: Q27.3 (C), V1.6 (C6), V2.6 (C6), V3.6 (C6), V4.6 (C6), V5.6 (C6), V6.6 (C6)
unnamed: Q28.1 (B), U16.11 (Y4)
unnamed: Q28.2 (E), R77.1
unnamed: Q28.3 (C), Q30.1 (B), R76.2
unnamed: Q29.1 (B), R78.1
unnamed: Q30.3 (C), R80.1
unnamed: Q31.1 (B), R79.1
unnamed: Q31.3 (C), V1.5 (C7), V2.5 (C7), V3.5 (C7), V4.5 (C7), V5.7 (C7), V6.7 (C7)
unnamed: Q32.1 (B), U16.10 (Y5)
unnamed: Q32.2 (E), R83.1
unnamed: Q32.3 (C), Q35.1 (B), R82.2
unnamed: Q33.1 (B), R84.1
unnamed: Q34.1 (B), R85.1
unnamed: Q34.3 (C), V1.4 (C8), V2.4 (C8), V3.4 (C8), V4.4 (C8), V5.8 (C8), V6.8 (C8)
unnamed: Q35.3 (C), R87.1
unnamed: Q36.1 (B), R88.1
unnamed: Q36.3 (C), V1.3 (C9), V2.3 (C9), V3.3 (C9), V4.3 (C9), V5.9 (C9), V6.9 (C9)
unnamed: Q37.1 (B), R89.1
unnamed: R34.2, U12.4 (P0)
unnamed: R37.2, U12.5 (P1)
unnamed: R40.2, U13.3 (0)
unnamed: R43.2, U13.14 (1)
unnamed: R44.2, U15.15 (Y0)
unnamed: R45.2, U15.13 (Y2)
unnamed: R51.2, V1.1 (A)
unnamed: R52.2, U13.2
unnamed: R53.2, U14.14 (Y1)
unnamed: R54.2, U15.14 (Y1)
unnamed: R55.2, U15.12 (Y3)
unnamed: R59.2, U13.15 (3)
unnamed: R60.2, U14.13 (Y2)
unnamed: R61.2, V2.1 (A)
unnamed: R62.2, U13.1 (4)
unnamed: R66.2, U14.12 (Y3)
unnamed: R67.2, V3.1 (A)
unnamed: R68.2, U13.6 (5)
unnamed: R72.2, U14.11 (Y4)
unnamed: R73.2, U13.7 (6)
unnamed: R74.2, V4.1 (A)
unnamed: R78.2, U14.10 (Y5)
unnamed: R79.2, U13.4 (7)
unnamed: R80.2, V5.11 (A)
unnamed: R84.2, U14.9 (Y6)
unnamed: R85.2, U13.9 (8)
unnamed: R87.2, V6.11 (A)
unnamed: R88.2, U13.5 (9)
unnamed: R89.2, U14.7 (Y7)
unnamed: U11.4 (P0), U13.10 (A)
unnamed: U11.5 (P1), U13.13 (B)
unnamed: U11.6 (P2), U13.12 (C)
unnamed: U11.7 (P3), U13.11 (D)
unnamed: U11.9 (P4), U16.3 (A2)
unnamed: U11.10 (P5), U16.2 (A1)
unnamed: U11.11 (P6), U16.1 (A0)
unnamed: U12.6 (P2), U15.1 (A0)
unnamed: U12.7 (P3), U15.2 (A1)
unnamed: U12.9 (P4), U14.1 (A0)
unnamed: U12.10 (P5), U14.2 (A1)
unnamed: U12.11 (P6), U14.3 (A2)
SCL: U11.14 (SCL), U12.14 (SCL); also elsewhere on the board
SDA: U11.15 (SDA), U12.15 (SDA); also elsewhere on the board

Notes on the sheet:
Sunday
Monday
Tuesday
Wednesday
Thursday
Friday
Saturday
Date
Weather
Alarm 1
Alarm 2
Colon
ADDR 32
ADDR 33

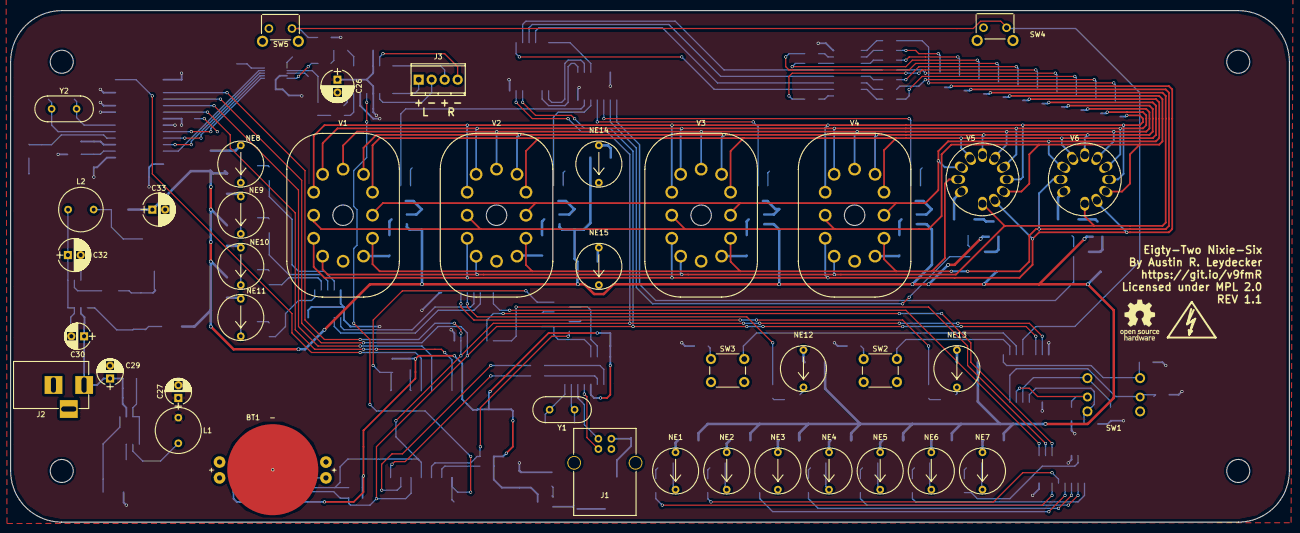
[picture p18: board NixieClock.kicad_pcb from above]

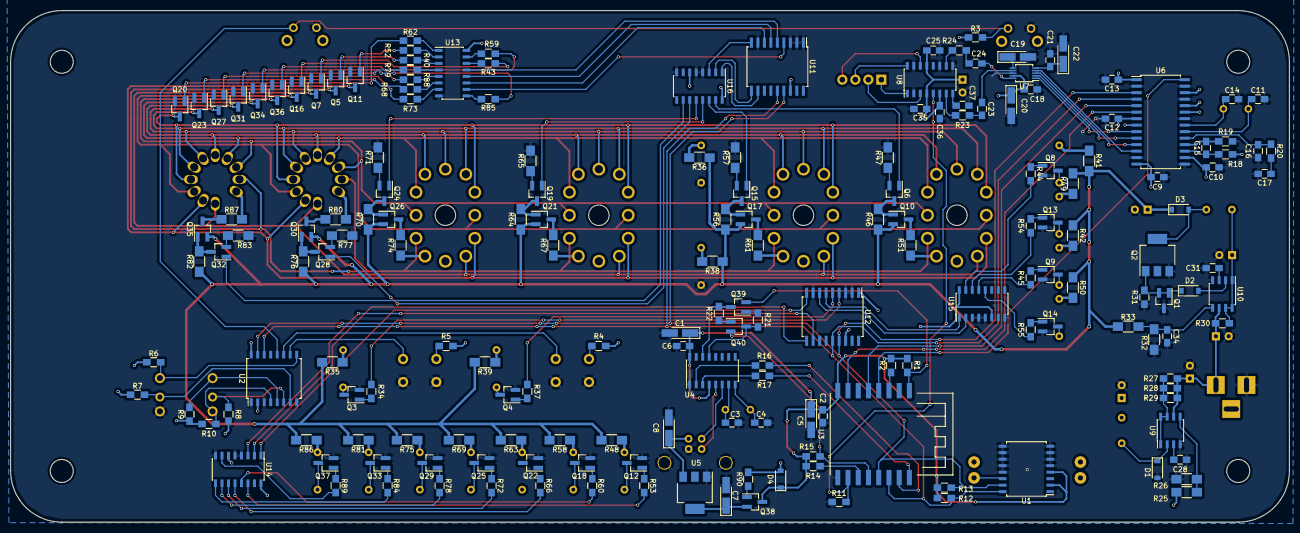
[picture p19: board NixieClock.kicad_pcb from below]

Board: 2 copper layers, 250.0 x 100.0 mm, 221 parts (181 on the bottom side), 198 nets.
