Renkin42/82Nix6/(commit log)

2017-04-11 Add initial pcb files
    [BatteryHolder.FCStd, MP3_Decoder.sch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]
2017-04-11 Added notes to speaker output terminal block
    [NixieClock-B.Cu.gbl, NixieClock-B.Mask.gbs, NixieClock-B.Paste.gbp, NixieClock-B.SilkS.gbo, NixieClock-Edge.Cuts.gm1, NixieClock-F.Cu.gtl, NixieClock-F.Mask.gts, NixieClock-F.SilkS.gto]
2017-04-17 Use RTS and DTR for flashing instead of switch
    [MP3_Decoder.sch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]
2017-04-18 Added model for ESP12. Updated schematic exports.
    [ESPModule.FCStd, MP3_Decoder.sch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]
2017-04-21 Switched to nodemcu-style flashing circuitry.
    [MP3_Decoder.sch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]
2017-04-21 Swapped Q2 for cheaper STN1NK60Z. Fixed some ground plane issues.
    [NixieClock-B.Cu.gbl, NixieClock-B.Mask.gbs, NixieClock-B.Paste.gbp, NixieClock-B.SilkS.gbo, NixieClock-Edge.Cuts.gm1, NixieClock-F.Cu.gtl, NixieClock-F.Mask.gts, NixieClock-F.SilkS.gto]
